gabrielgr04072005-ai/TCC-Fatec-Sistema-de-monitoramento-CNC/Imagens/Amperimetro.jpeg

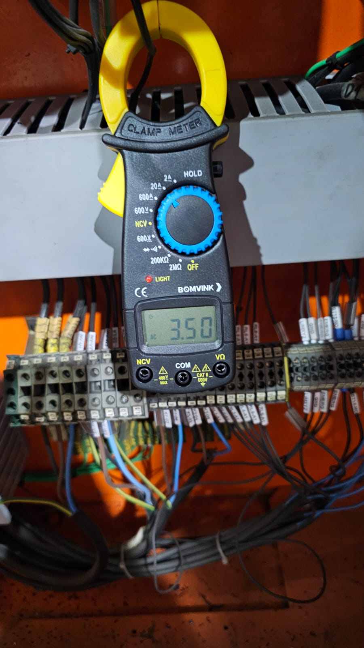
Imagens/Amperimetro.jpeg
