gabrielgr04072005-ai/TCC-Fatec-Sistema-de-monitoramento-CNC/README.md

# TCC Fatec Sistema de monitoramento CNC
Sistema de monitoramento de máninhas CNC da empressa AMJ
