gabrielgr04072005-ai/TCC-Fatec-Sistema-de-monitoramento-CNC/Melhorias/Melhorias_TCC_IIOT_Tamboreadoras.docx

# Plano de Melhorias do TCC – Sistema de Monitoramento de Tamboreadoras Industriais Baseado em IIoT

Principais observações da banca:
A ideia do projeto foi considerada relevante e aplicável, porém faltam detalhamento técnico, fundamentação das decisões, definição clara do problema e melhor estruturação metodológica.

## 1. Melhorar a definição do problema

Descrever o problema atual da empresa antes de apresentar a solução. Explicar a dependência de coletas manuais, deslocamento de técnicos, falta de histórico confiável, erros de registro e dificuldades na manutenção preventiva.

## 2. Caracterizar melhor a empresa

Informar quantidade de tamboreadoras, operadores, técnicos, turnos, frequência das coletas e volume de leituras realizadas.

## 3. Inserir métricas atuais

Apresentar indicadores da situação atual para futura comparação, como tempo médio de coleta, deslocamento, erros de registro e disponibilidade.

## 4. Detalhar os KPIs

Explicar MTBF, MTTR e Disponibilidade, incluindo fórmulas e aplicação no projeto.

## 5. Justificar a escolha da corrente elétrica

Demonstrar por que a corrente foi escolhida, quais benefícios oferece e quais limitações possui.

## 6. Comparar tecnologias alternativas

Apresentar comparação entre método manual, software CMMS, CLP industrial e solução IIoT baseada em ESP32.

## 7. Revisar a utilização do TinyML

Evitar prometer implementação sem definição clara. Apresentar como possibilidade futura da arquitetura.

## 8. Detalhar a arquitetura proposta

Explicar individualmente sensor, ESP32, MQTT, banco de dados, dashboard e usuários.

## 9. Explicar modo online e offline

Detalhar comportamento do sistema quando houver conexão e quando houver falha de comunicação.

## 10. Definir frequência de aquisição

Justificar tecnicamente o intervalo de coleta e transmissão dos dados.

## 11. Revisar inconsistências

Corrigir siglas, trechos indevidos, referências, formatação e erros de escrita.

## 12. Fortalecer a conclusão

Apresentar benefícios esperados, limitações e sugestões de trabalhos futuros.

## Resumo das ações prioritárias

- Explicar claramente o problema.
- Caracterizar a empresa e o processo.
- Inserir métricas atuais e futuras.
- Detalhar KPIs.
- Justificar o uso da corrente elétrica.
- Comparar tecnologias alternativas.
- Reduzir dependência do TinyML no TCC I.
- Detalhar arquitetura.
- Explicar operação online e offline.
- Definir frequência de coleta.
- Revisar todo o documento.
- Ampliar a conclusão.
