gabrielgr04072005-ai/TCC-Fatec-Sistema-de-monitoramento-CNC/Imagens/arquitetura_autoencoder_10_8_4_8_10_v1.png

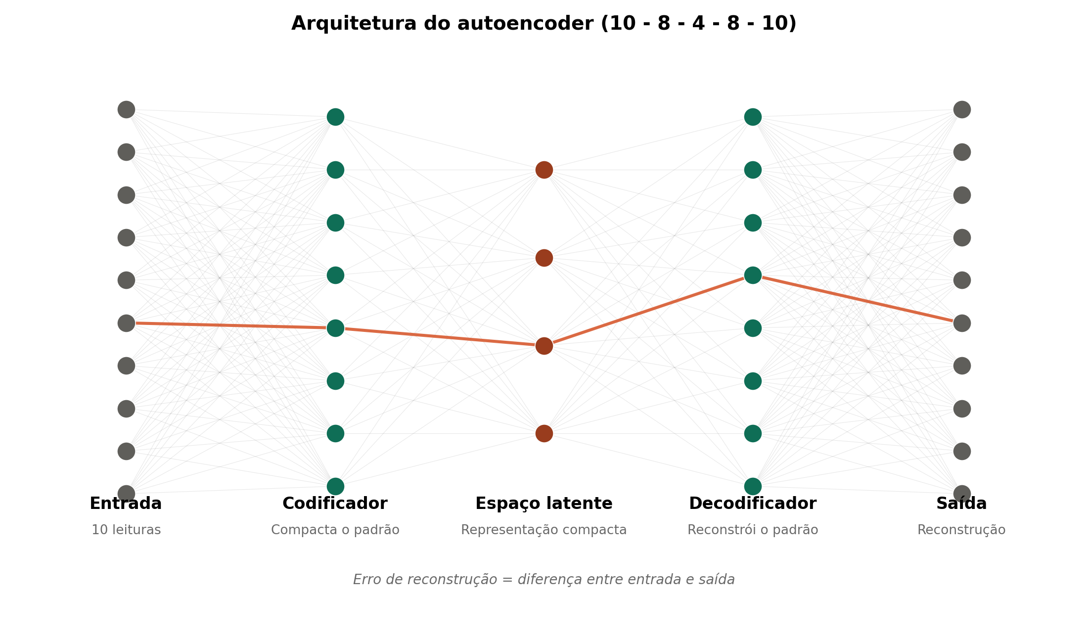
Imagens/arquitetura_autoencoder_10_8_4_8_10_v1.png
