gabrielgr04072005-ai/TCC-Fatec-Sistema-de-monitoramento-CNC/Imagens/autoencoder_4_2_4_v1.png

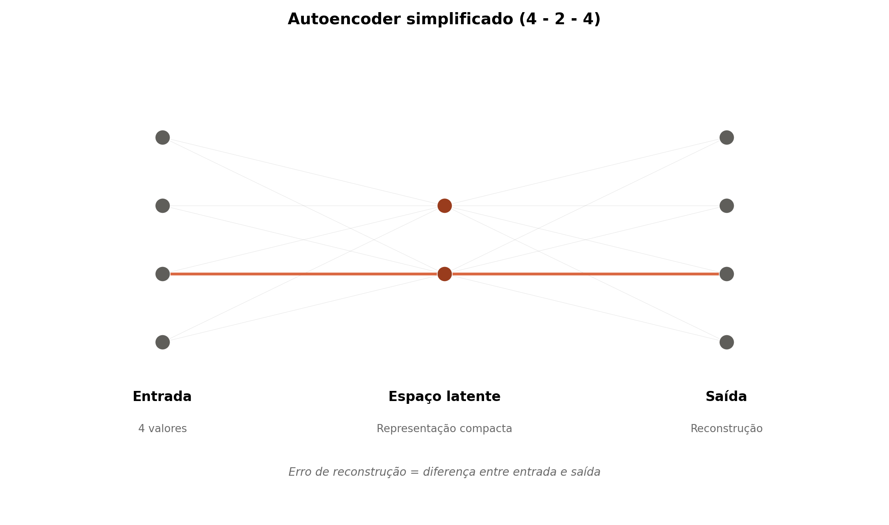
Imagens/autoencoder_4_2_4_v1.png
