gabrielgr04072005-ai/TCC-Fatec-Sistema-de-monitoramento-CNC/Imagens/Circuito_completo.jpg

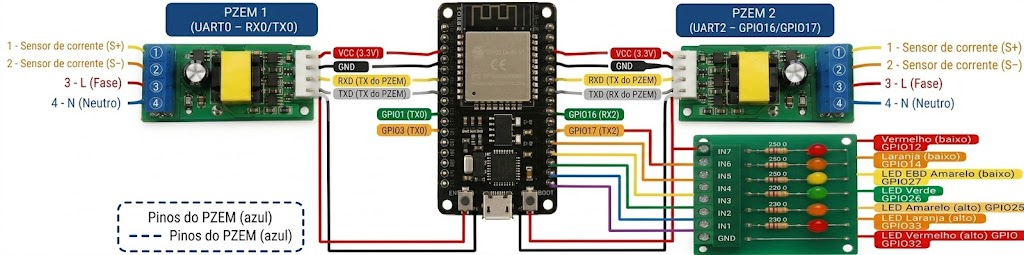
Imagens/Circuito_completo.jpg
