gabrielgr04072005-ai/TCC-Fatec-Sistema-de-monitoramento-CNC/Imagens/ESP32_circuito.png

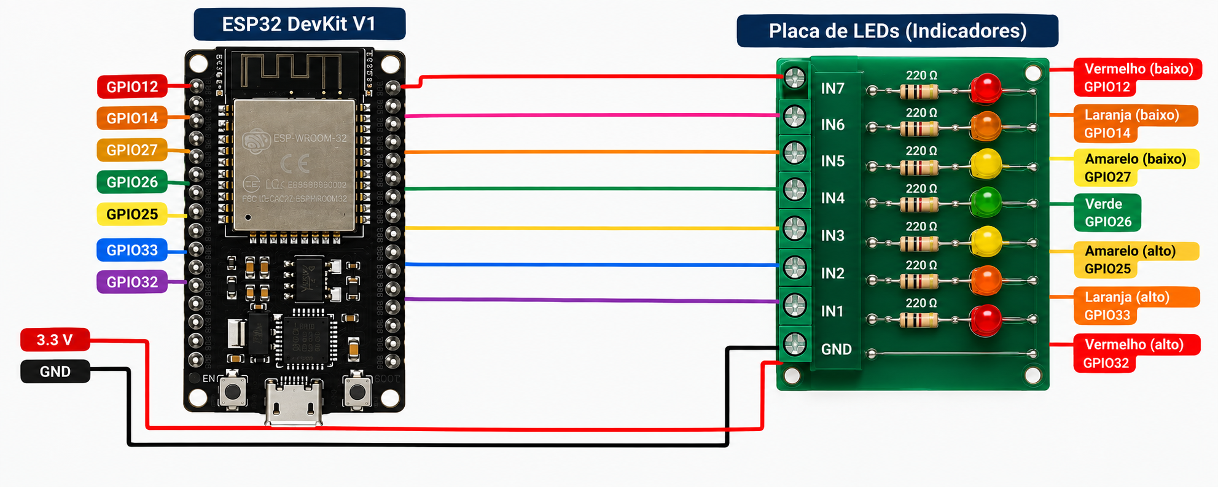
Imagens/ESP32_circuito.png
