gabrielgr04072005-ai/TCC-Fatec-Sistema-de-monitoramento-CNC/Imagens/Fluxograma.png

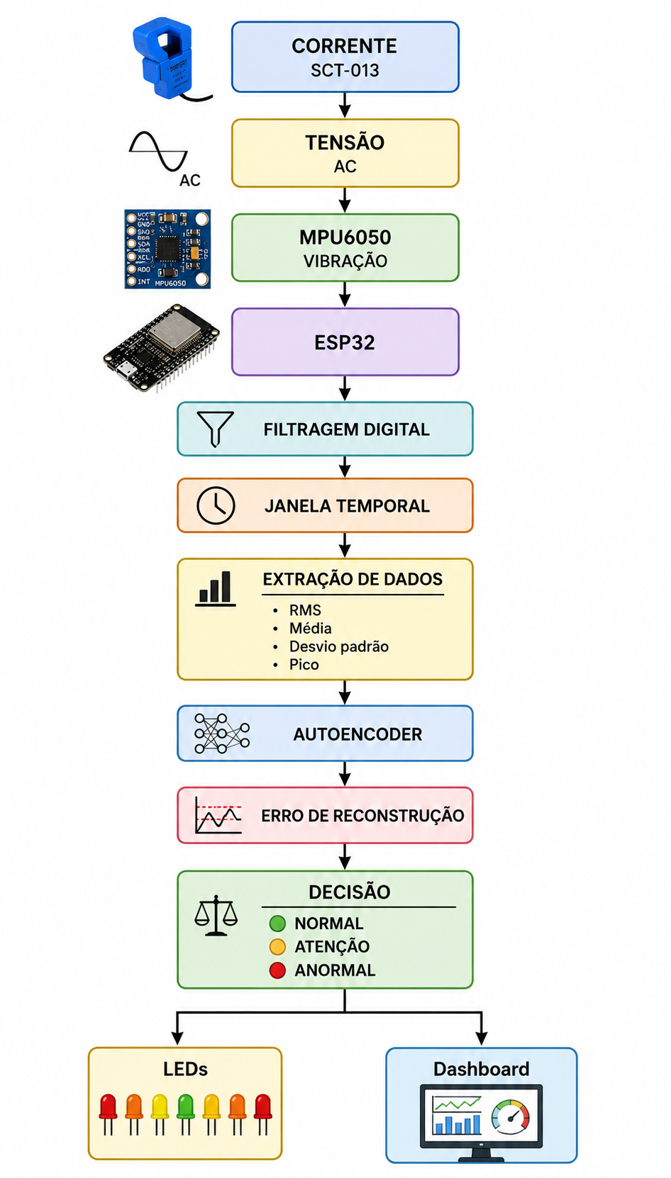
Imagens/Fluxograma.png
