gabrielgr04072005-ai/TCC-Fatec-Sistema-de-monitoramento-CNC/Imagens/Gráfico_ZScore03.10/grafico_leigo_2_mesma_escala.png

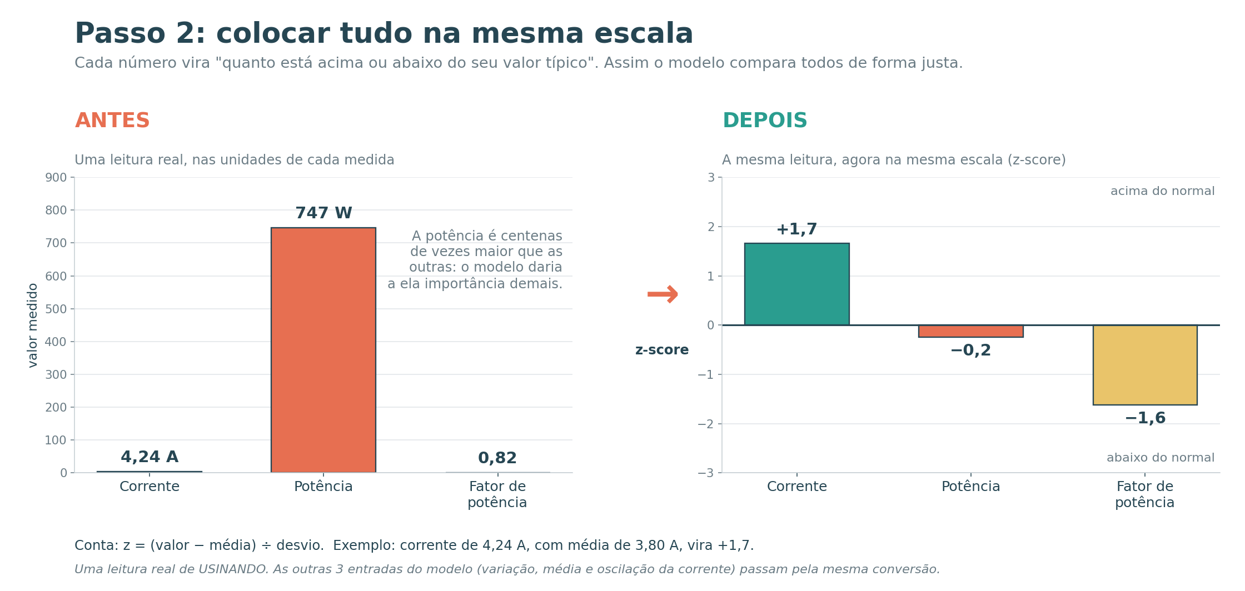
Imagens/Gráfico_ZScore03.10/grafico_leigo_2_mesma_escala.png
