gabrielgr04072005-ai/TCC-Fatec-Sistema-de-monitoramento-CNC/Imagens/Ligação_EPS_32_Pzem.png

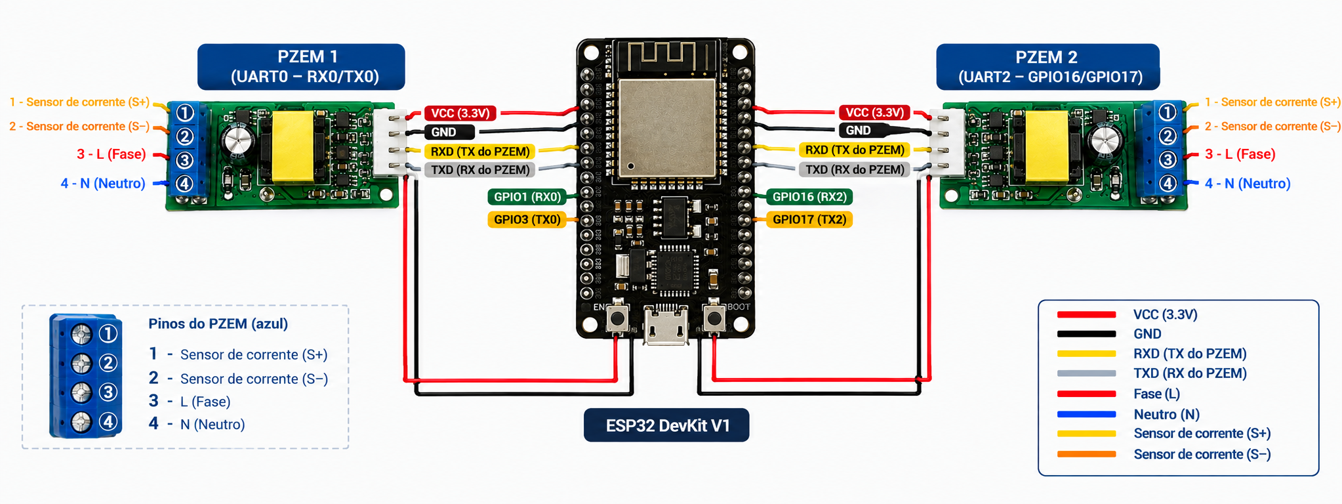
Imagens/Ligação_EPS_32_Pzem.png
