gabrielgr04072005-ai/TCC-Fatec-Sistema-de-monitoramento-CNC/Imagens/Máquina.jpeg

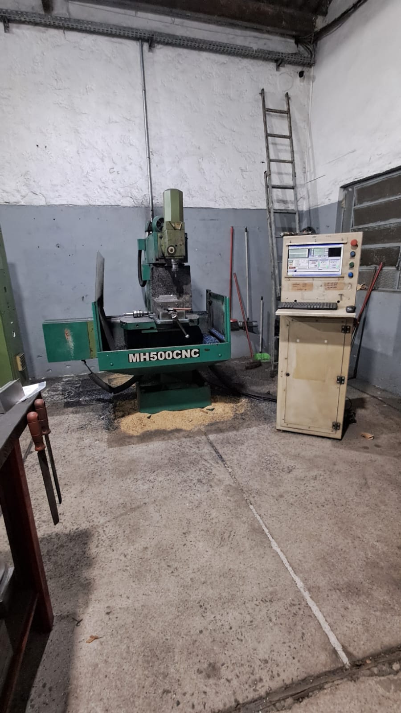
Imagens/Máquina.jpeg
