gabrielgr04072005-ai/TCC-Fatec-Sistema-de-monitoramento-CNC/Imagens/Máquina_operandop.jpeg

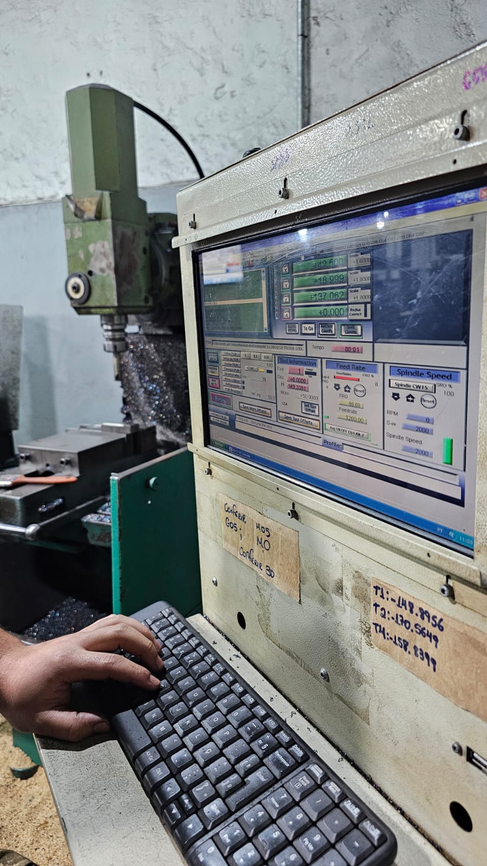
Imagens/Máquina_operandop.jpeg
