gabrielgr04072005-ai/TCC-Fatec-Sistema-de-monitoramento-CNC/Imagens/WhatsApp Image 2026-10-24 at 09.30.09.jpeg

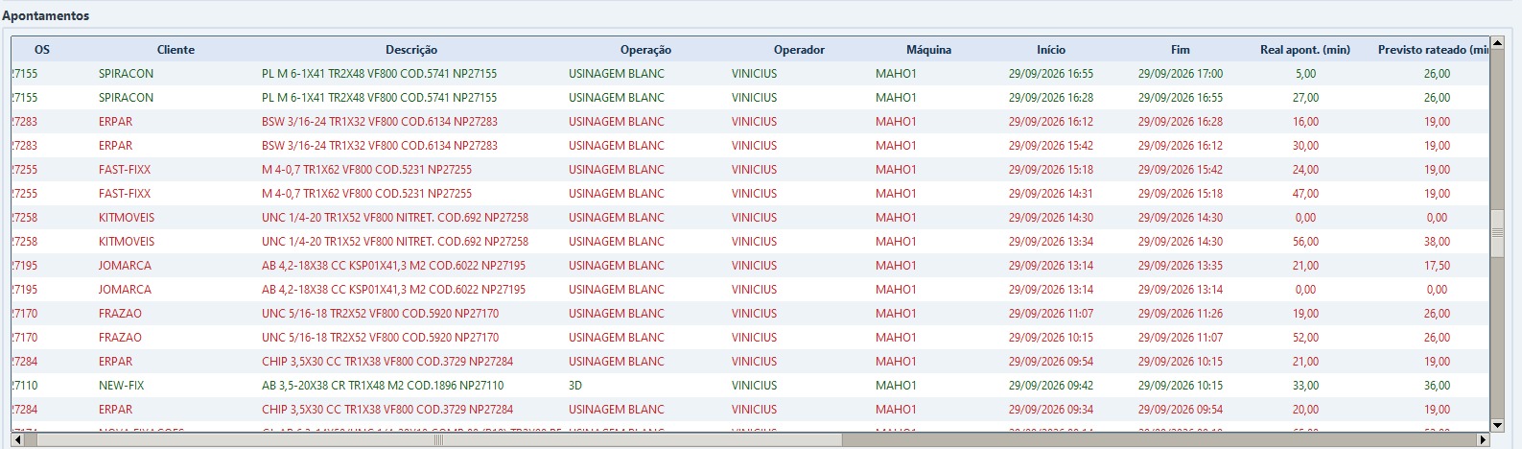
Imagens/WhatsApp Image 2026-10-24 at 09.30.09.jpeg
