gabrielgr04072005-ai/TCC-Fatec-Sistema-de-monitoramento-CNC/Mqtt/Dados brutos/Treino Autoencoder/Treino com o Z score local/boxplot_erro_por_nivel.png

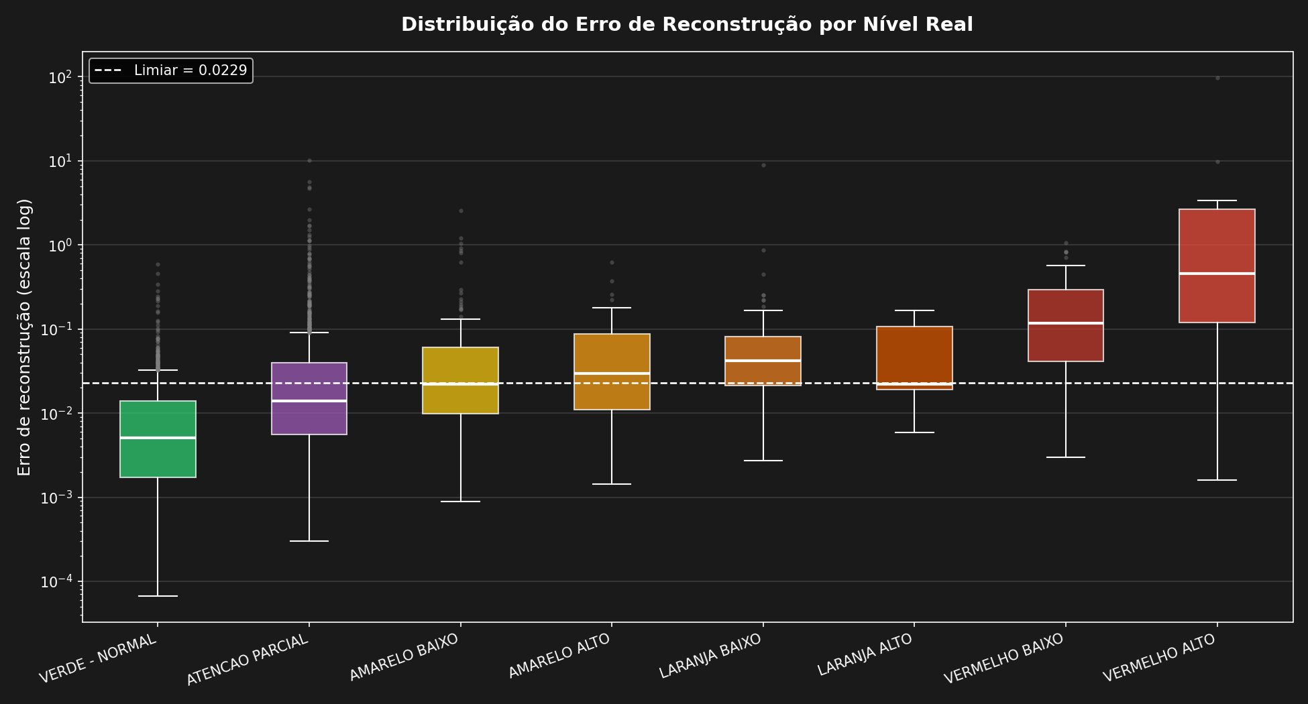
Mqtt/Dados brutos/Treino Autoencoder/Treino com o Z score local/boxplot_erro_por_nivel.png
