gabrielgr04072005-ai/TCC-Fatec-Sistema-de-monitoramento-CNC/Mqtt/Dados brutos/Treino Autoencoder/Treino com o Z score local/dispersao_corrente_vibracao.png

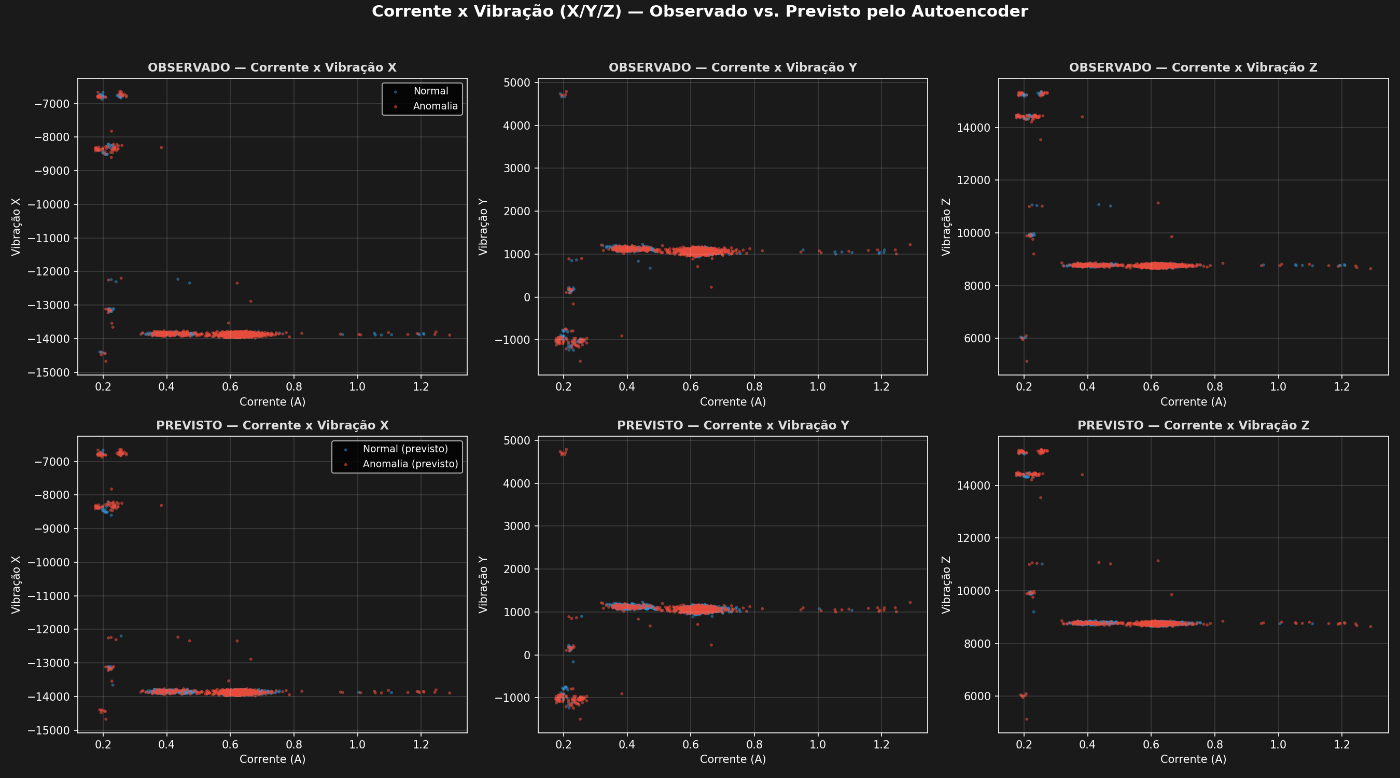
Mqtt/Dados brutos/Treino Autoencoder/Treino com o Z score local/dispersao_corrente_vibracao.png
