gabrielgr04072005-ai/TCC-Fatec-Sistema-de-monitoramento-CNC/Mqtt/Dados brutos/Treino Autoencoder/Treino com o Z score local/erro_tempo_observado_previsto.png

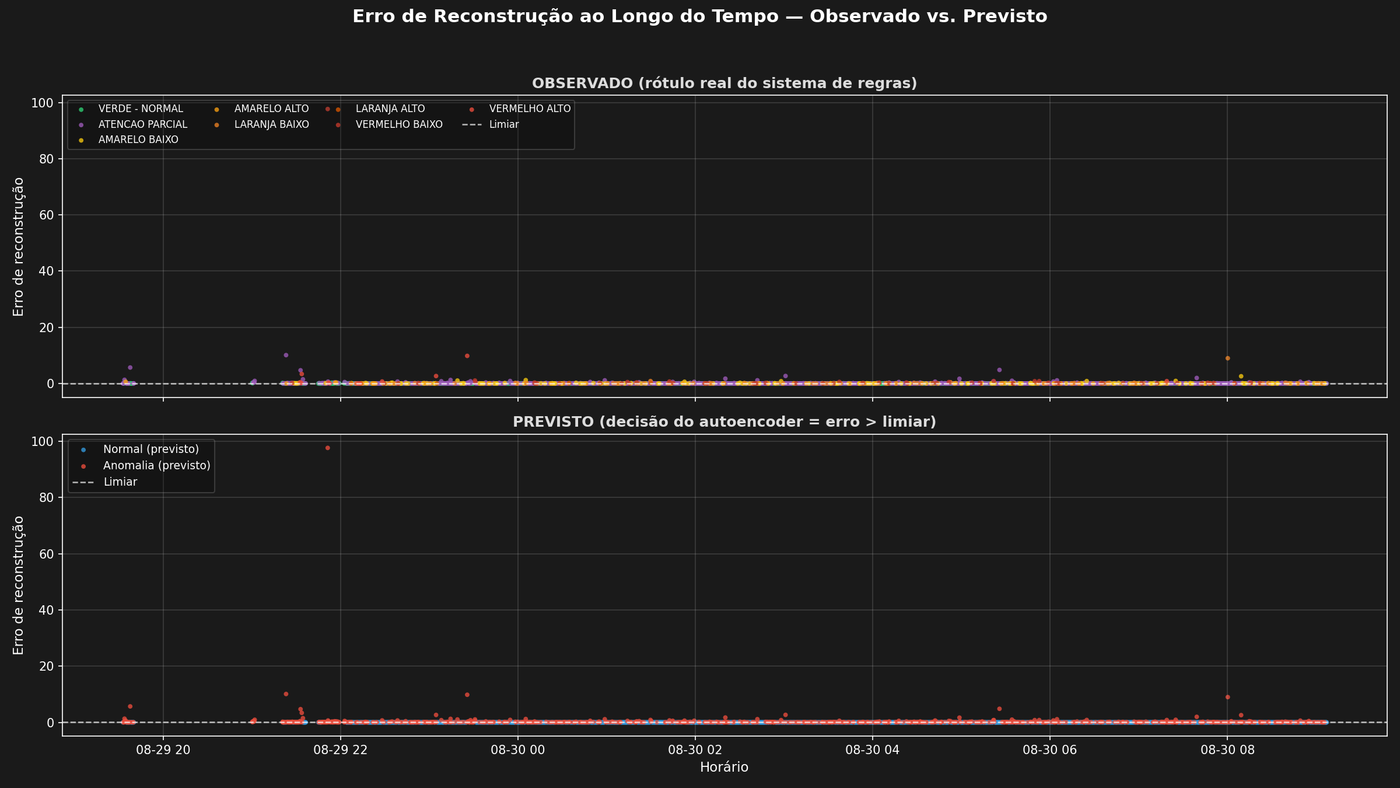
Mqtt/Dados brutos/Treino Autoencoder/Treino com o Z score local/erro_tempo_observado_previsto.png
