gabrielgr04072005-ai/TCC-Fatec-Sistema-de-monitoramento-CNC/Mqtt/Dados brutos/Treino Autoencoder/Treino com o Z score local/grafico_variaveis_v3c.png

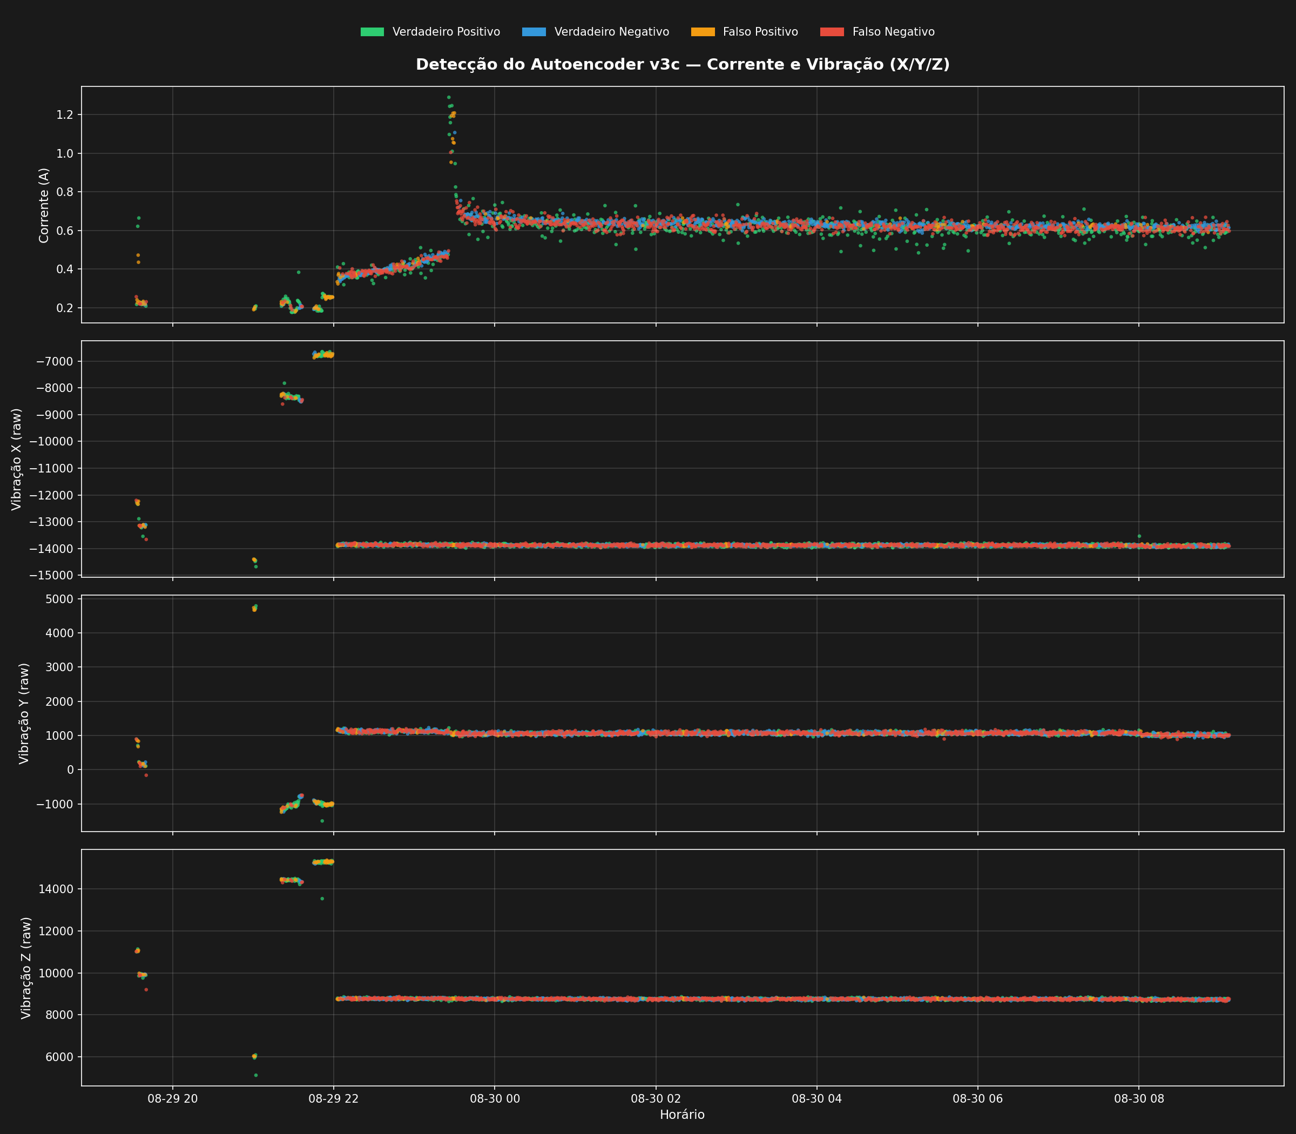
Mqtt/Dados brutos/Treino Autoencoder/Treino com o Z score local/grafico_variaveis_v3c.png
