gabrielgr04072005-ai/TCC-Fatec-Sistema-de-monitoramento-CNC/Treinamento TynML/amostra30.09/estrutura_rede_USINANDO.png

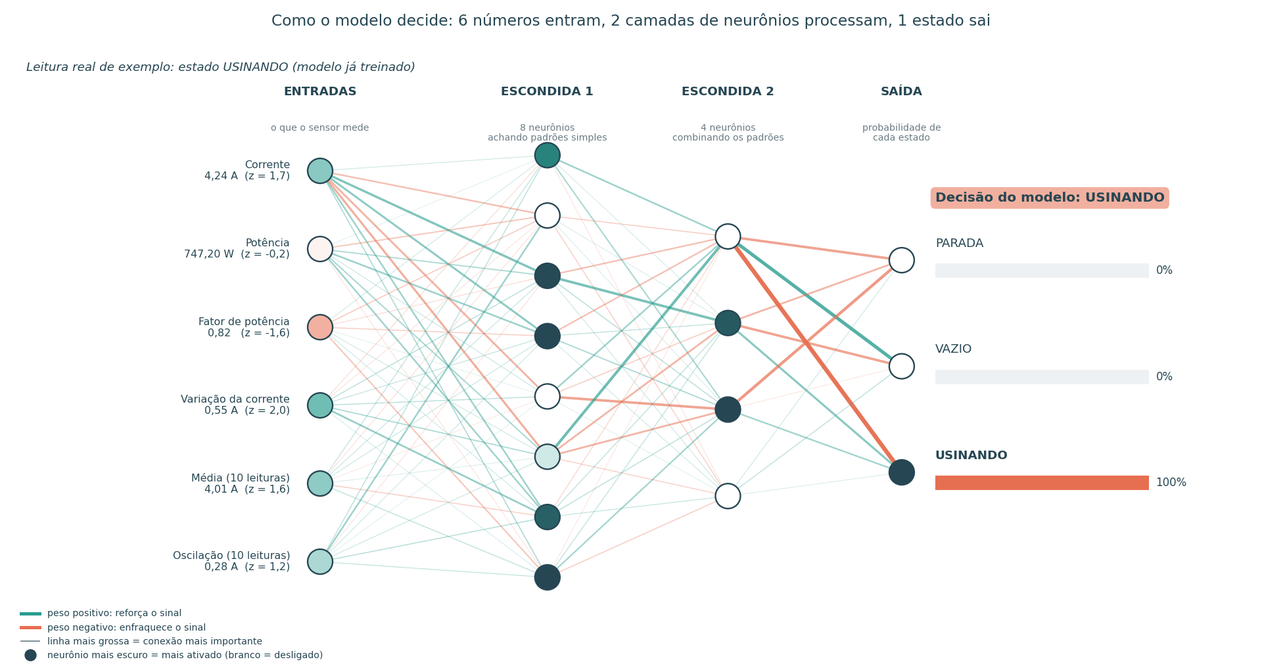
Treinamento TynML/amostra30.09/estrutura_rede_USINANDO.png
