gabrielgr04072005-ai/TCC-Fatec-Sistema-de-monitoramento-CNC/Treinamento TynML/amostra30.09/grafico_3d_variaveis.png

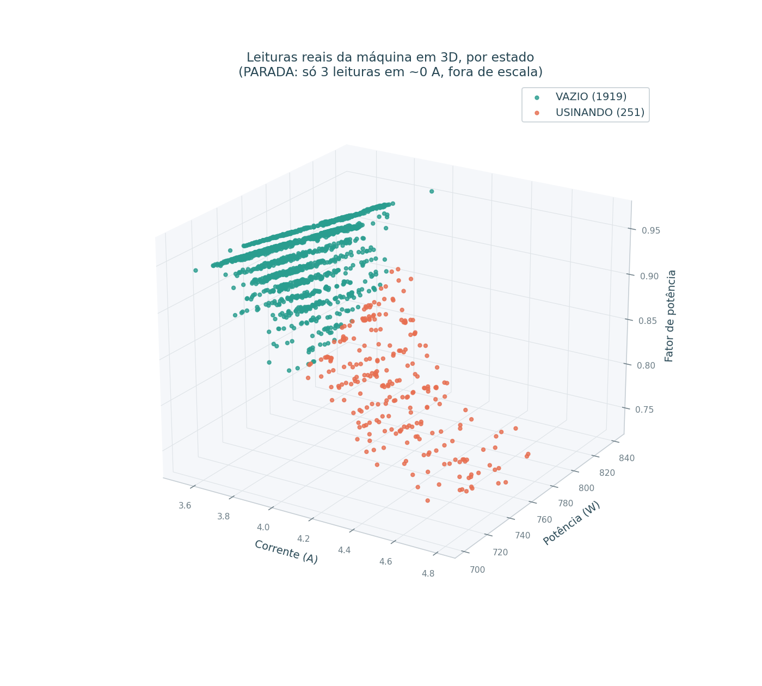
Treinamento TynML/amostra30.09/grafico_3d_variaveis.png
