gabrielgr04072005-ai/TCC-Fatec-Sistema-de-monitoramento-CNC/Treinamento TynML/amostra30.09/saida_tcc/estrutura_rede_VAZIO.png

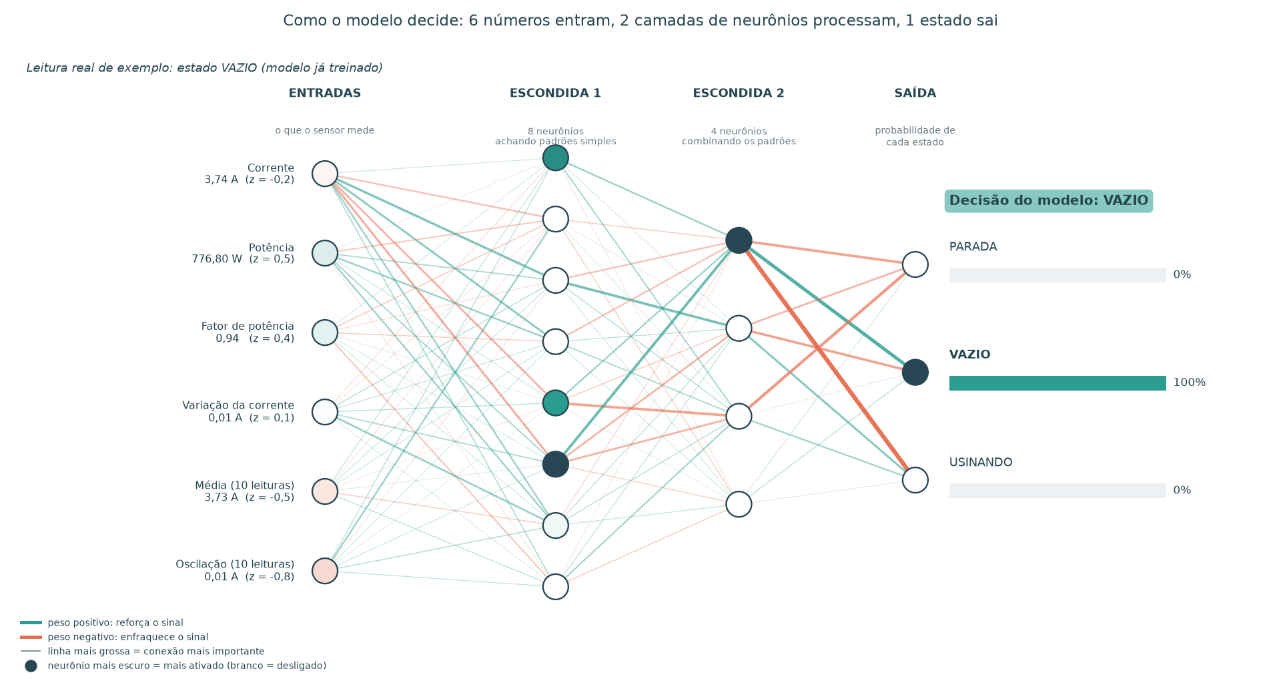
Treinamento TynML/amostra30.09/saida_tcc/estrutura_rede_VAZIO.png
