gabrielgr04072005-ai/TCC-Fatec-Sistema-de-monitoramento-CNC/Treinamento TynML/amostra30.09/saida_tcc/treino_animado.gif

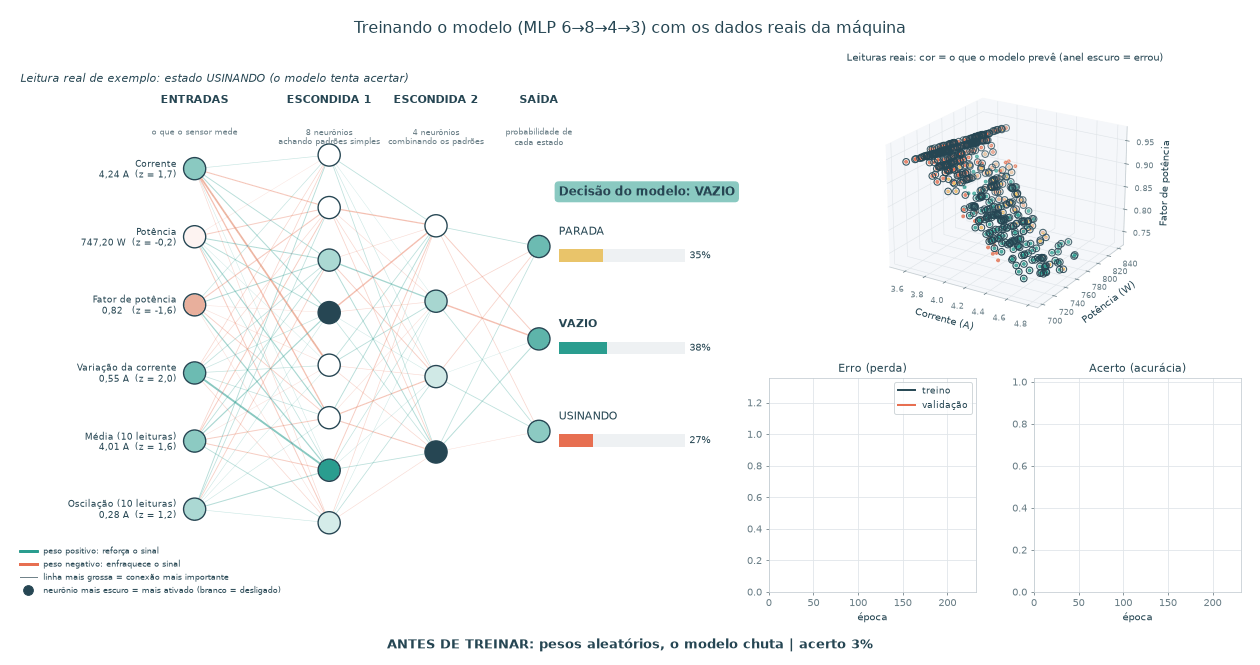
Treinamento TynML/amostra30.09/saida_tcc/treino_animado.gif
