gabrielgr04072005-ai/TCC-Fatec-Sistema-de-monitoramento-CNC/Treinamento TynML/Dados reais 23_08/leituras_reais_planilha.png

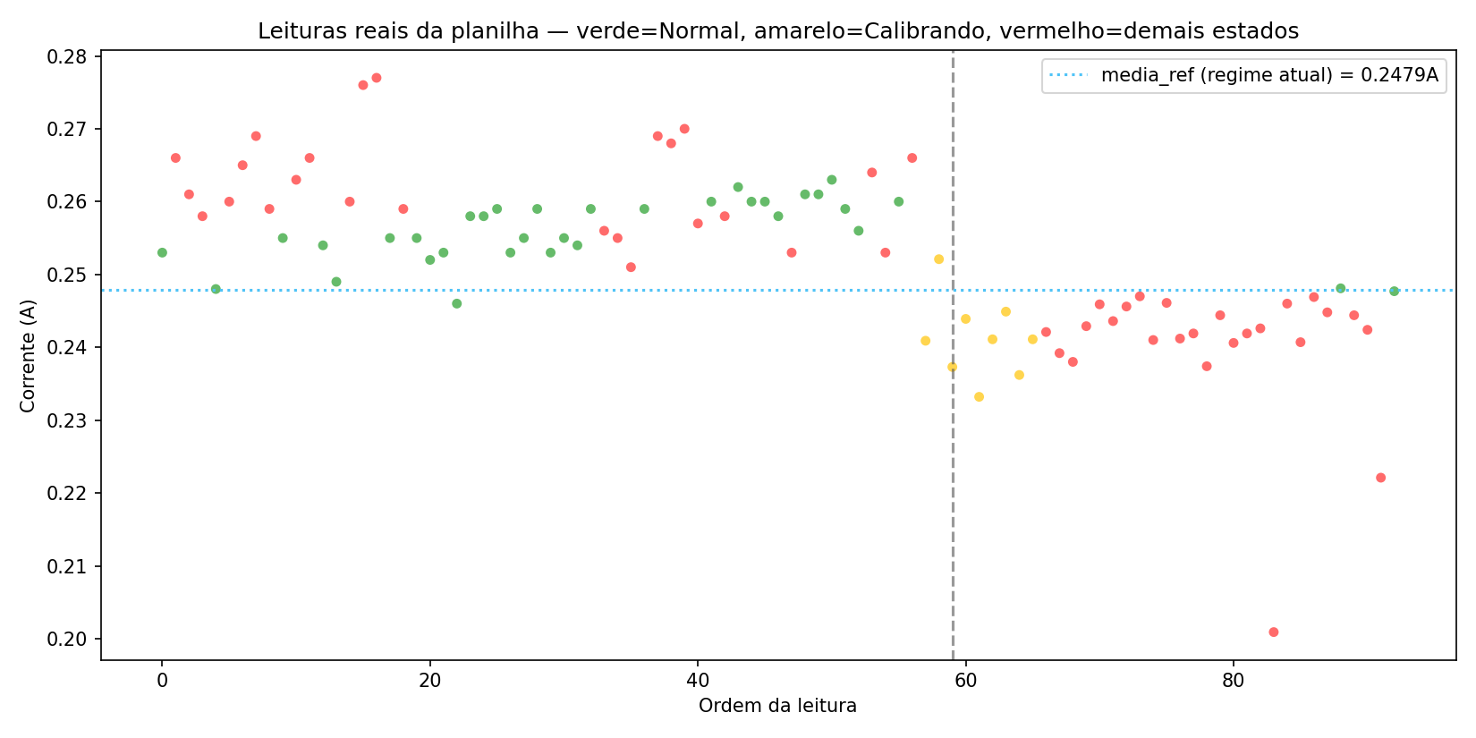
Treinamento TynML/Dados reais 23_08/leituras_reais_planilha.png
