gabrielgr04072005-ai/TCC-Fatec-Sistema-de-monitoramento-CNC/Treinamento TynML/Dados reais 23_08/matriz_confusao_dados_reais.png

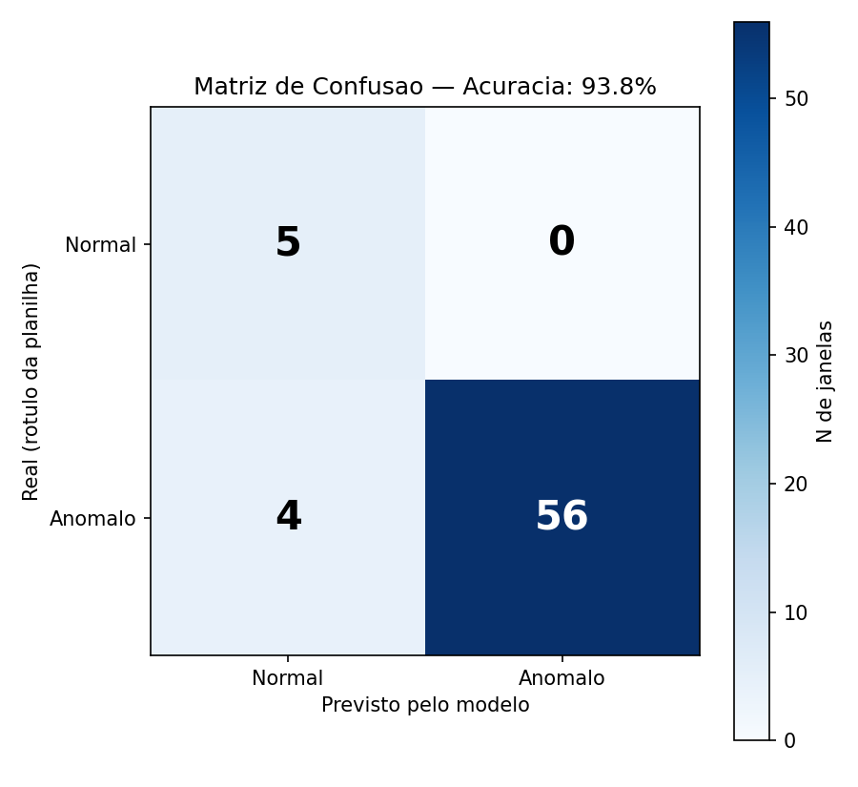
Treinamento TynML/Dados reais 23_08/matriz_confusao_dados_reais.png
