gabrielgr04072005-ai/TCC-Fatec-Sistema-de-monitoramento-CNC/Treinamento TynML/fluxo_deploy_autoencoder.png

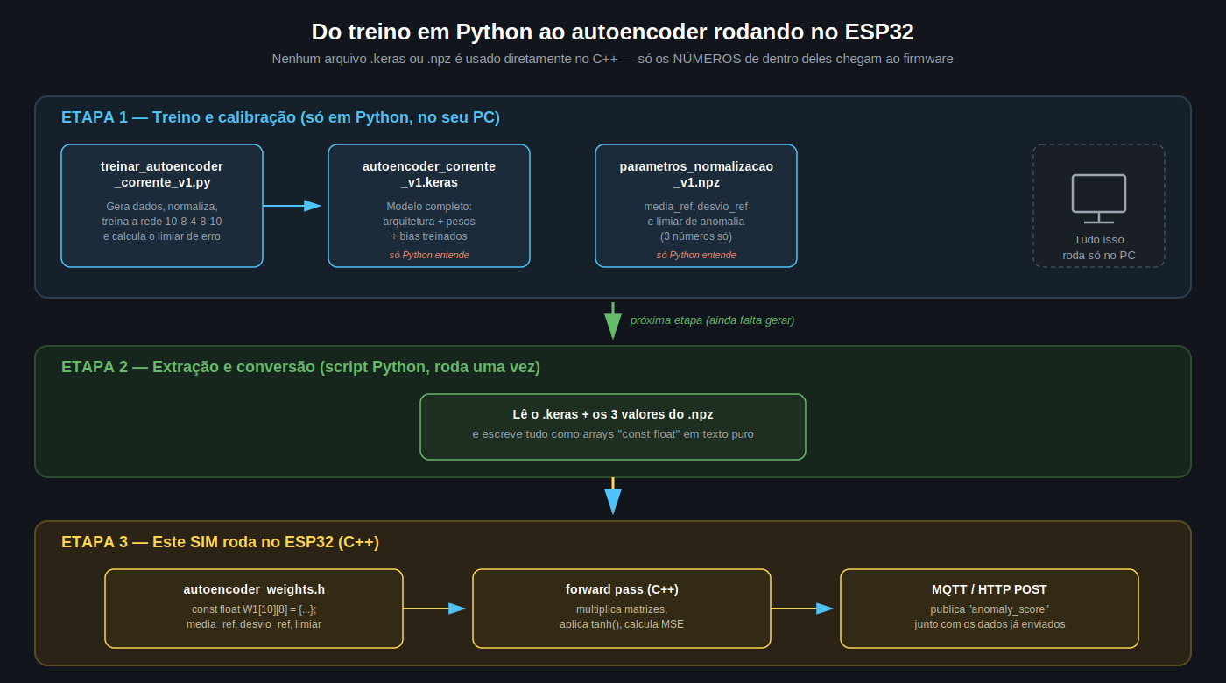
Treinamento TynML/fluxo_deploy_autoencoder.png
