gabrielgr04072005-ai/TCC-Fatec-Sistema-de-monitoramento-CNC/Treinamento TynML/Treinameto_25a26do9/treinamento_visual.png

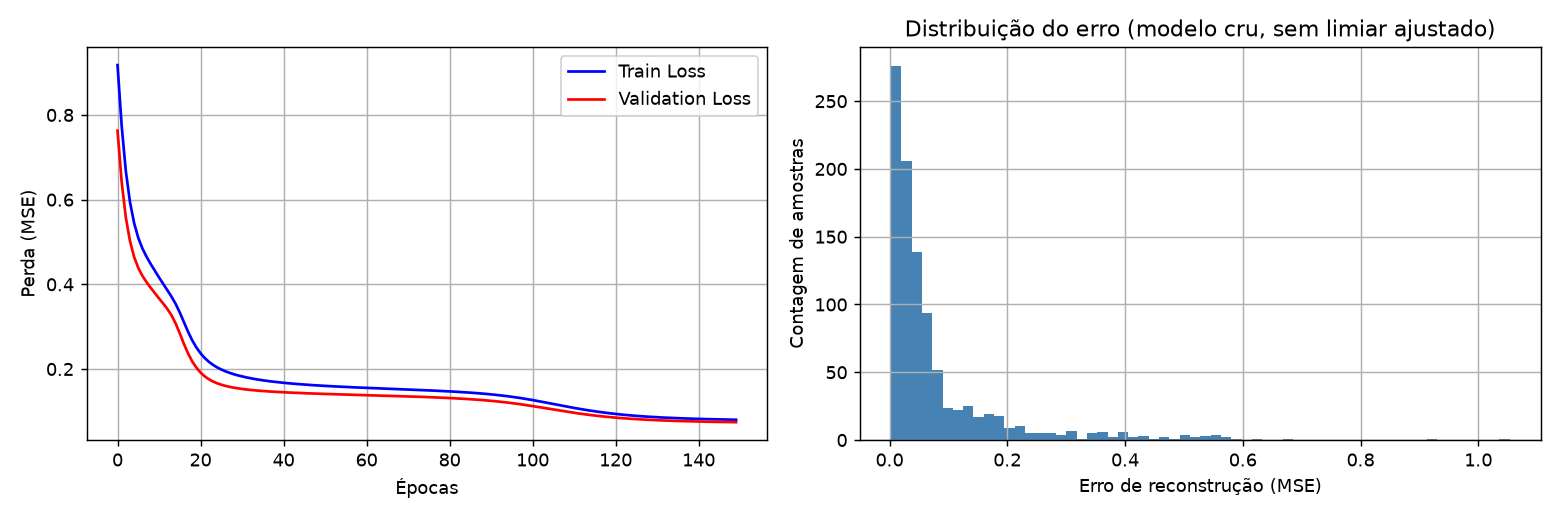
Treinamento TynML/Treinameto_25a26do9/treinamento_visual.png
