gabrielgr04072005-ai/TCC-Fatec-Sistema-de-monitoramento-CNC/material de estudo/Material de apoio.docx

1. Primeiro: o que é Machine Learning?

Machine Learning é uma abordagem em que você não programa explicitamente todas as regras de decisão. Você fornece dados, e um algoritmo encontra relações nesses dados para produzir uma previsão ou classificação.

No seu projeto, em vez de programar somente:

corrente > 4 A → USINANDO

corrente < 4 A → VAZIO

você fornece ao modelo várias características da máquina:

Corrente

Potência

Fator de potência

Variação da corrente

Média da corrente

Desvio-padrão da corrente

e ele aprende uma relação entre essas entradas e os rótulos de operação.

A ideia geral é:

DADOS

↓

ALGORITMO DE APRENDIZADO

↓

MODELO TREINADO

↓

NOVOS DADOS

↓

PREDIÇÃO

2. Onde entra o MLP?

MLP significa:

Multilayer Perceptron

ou

Perceptron Multicamadas.

É uma rede neural artificial.

A palavra "multicamadas" é importante porque ela não possui somente um neurônio ou uma única camada. Ela possui:

ENTRADA

↓

CAMADA OCULTA 1

↓

CAMADA OCULTA 2

↓

SAÍDA

No seu caso:

6 → 8 → 4 → 3

Ou seja:

6 entradas

↓

8 neurônios

↓

4 neurônios

↓

3 neurônios

A estrutura do seu projeto está documentada exatamente dessa forma.

3. O que é um neurônio?

O neurônio artificial é uma unidade matemática.

Ele recebe várias entradas, multiplica cada entrada por um peso, soma tudo, adiciona um viés e depois passa o resultado por uma função de ativação.

A equação é:

z=w_1 x_1 +w_2 x_2 +⋯+w_n x_n +b

Depois:

a=f(z)

Onde:

x = entrada
w = peso
b = bias
z = soma ponderada
f = função de ativação
a = saída do neurônio

No documento do seu projeto, essa é justamente a operação definida para cada neurônio.

4. O que são os pesos?

Essa é uma das coisas mais importantes para entender.

Imagine que o modelo receba:

Corrente = 4,2 A

Potência = 800 W

Fator de potência = 0,91

O modelo precisa descobrir quanto cada variável influencia a decisão.

Por exemplo, conceitualmente:

Corrente → peso grande

Potência → peso médio

Fator de pot. → peso menor

Esses números são os pesos.

Durante o treinamento, o modelo vai alterando esses valores.

Por isso você pode pensar:

O aprendizado da rede acontece principalmente pelo ajuste dos pesos e vieses.

No seu MLP existem 107 parâmetros treináveis. Isso inclui pesos e vieses.

E dá para conferir:

Primeira camada

6 entradas × 8 neurônios:

6×8=48

Mais 8 vieses:

48+8=56

Segunda camada

8 × 4:

8×4=32

Mais 4 vieses:

32+4=36

Saída

4 × 3:

4×3=12

Mais 3 vieses:

12+3=15

Total:

56+36+15=107

Portanto, os 107 "ajustes" que aparecem no material estão corretos.

5. Como a sua rede funciona na prática?

Imagine uma leitura da máquina:

Corrente = 4,24 A

Potência = ...

Fator de potência = ...

Variação = ...

Média = ...

Desvio padrão = ...

Primeiro os valores passam pelo pré-processamento.

No seu projeto, há tratamento de outliers com MAD e normalização por z-score.

Depois:

6 valores

↓

NORMALIZAÇÃO

↓

MLP

A primeira camada recebe os seis valores.

Cada um dos 8 neurônios calcula:

z=Wx+b

e aplica ReLU.

Depois esses 8 resultados passam para os 4 neurônios da segunda camada.

Novamente:

z=Wx+b

e ReLU.

Finalmente os quatro valores chegam aos três neurônios de saída.

6. Por que ReLU?

No seu projeto, as duas camadas ocultas usam ReLU.

A função é:

ReLU(x)=max⁡(0, x)

Então:

x < 0 → 0

x > 0 → x

Exemplo:

-3 → 0

-1 → 0

0 → 0

2 → 2

5 → 5

A ReLU introduz uma não linearidade na rede.

Isso é fundamental.

Sem funções de ativação não lineares, várias camadas lineares poderiam ser matematicamente reduzidas a uma transformação linear única. Assim, a rede teria dificuldade para representar fronteiras mais complexas entre os estados.

Seu material explica exatamente essa motivação para a escolha da ReLU.

7. E a saída? Por que softmax?

Você possui três saídas:

PARADA

VAZIO

USINANDO

A camada de saída usa softmax.

Ela transforma as pontuações da rede em probabilidades que somam 100%.

Por exemplo:

PARADA = 0,05

VAZIO = 0,15

USINANDO = 0,80

Então:

PARADA 5%

VAZIO 15%

USINANDO 80%

O modelo escolhe:

USINANDO

porque é a maior probabilidade.

8. O que acontece no Forward Propagation?

Esse é o primeiro grande passo do funcionamento da rede.

O dado vai:

ENTRADA

↓

CAMADA 1

↓

CAMADA 2

↓

SAÍDA

Por isso é chamado de forward propagation, ou propagação direta.

No seu projeto:

6 variáveis

↓

8 neurônios + ReLU

↓

4 neurônios + ReLU

↓

3 neurônios + Softmax

↓

probabilidades

Seu documento resume exatamente essa sequência.

9. Mas como a rede sabe que errou?

Aí entra a função de perda (loss).

Suponha que a resposta correta seja:

USINANDO

Mas o modelo respondeu:

PARADA 40%

VAZIO 29%

USINANDO 31%

Ele errou.

A função de perda mede o tamanho desse erro.

No seu projeto é utilizada entropia cruzada categórica.

A equação, no caso simplificado de uma classe correta, fica:

L=-ln⁡(p)

onde p é a probabilidade que o modelo atribuiu à classe correta.

Se a rede der 90% para a classe correta:

L=-ln⁡(0, 9)≈0,11

Erro pequeno.

Se der apenas 10%:

L=-ln⁡(0, 1)≈2,30

Erro muito maior.

Isso faz com que a rede seja fortemente penalizada quando erra com confiança.

10. Agora chegamos ao BACKPROPAGATION

Esse é provavelmente o ponto que você mais precisa dominar.

A imagem que você enviou mostra o processo em nove passos.

Vamos adaptar os nove passos para a sua MLP.

PASSO 1 — Inicializar os pesos

Antes de aprender, a rede precisa possuir pesos.

No seu treinamento, eles começam com valores iniciais aleatórios.

w₁ = ...

w₂ = ...

w₃ = ...

No início a rede ainda não sabe nada.

Então ela praticamente "chuta".

O seu material mostra essa condição como a época inicial do treinamento.

11. PASSO 2 — Propagar a entrada até a saída

Agora entra uma leitura real da máquina.

Por exemplo:

x₁ = corrente

x₂ = potência

x₃ = fator de potência

x₄ = Δ corrente

x₅ = média

x₆ = desvio padrão

Esses seis valores passam pelas camadas:

6

↓

8

↓

4

↓

3

Esse é o forward propagation.

12. PASSO 3 — Calcular o erro

A saída pode ser:

PARADA 5%

VAZIO 64%

USINANDO 31%

Mas o rótulo real é:

USINANDO

A função de perda calcula:

L=-ln⁡(0, 31)

aproximadamente:

L=1,16

Esse exemplo aparece diretamente no material do treinamento.

13. O que é o delta?

O delta está relacionado ao erro que precisa ser propagado para trás para determinar como cada parâmetro deve ser ajustado.

Em termos intuitivos:

"Quanto esse neurônio/peso contribuiu para o erro?"

O cálculo vem da aplicação da regra da cadeia e das derivadas.

É por isso que você vê:

(∂L)/(∂w)

Essa expressão significa:

quanto a perda L muda quando alteramos um determinado peso w .

O documento explica o gradiente justamente como a inclinação da perda em relação a cada peso.

14. PASSO 4 — Ajustar os pesos da saída

Agora sabemos para que lado o peso precisa mudar.

A atualização conceitual é:

w_(novo) =w_(antigo) -η(∂L)/(∂w)

Onde:

- w = peso;
- L = perda;
- (∂L)/(∂w) = gradiente;
- η = taxa de aprendizado.

No seu treinamento, o Adam parte de:

η=0,001

15. PASSO 5 — Voltar para a última camada oculta

Depois de corrigir o erro da saída, o algoritmo continua voltando.

Por isso o nome:

backpropagation

"Back" = para trás.

"Propagation" = propagação.

Então:

SAÍDA

↓

CAMADA OCULTA 2

↓

CAMADA OCULTA 1

↓

ENTRADAS

O algoritmo calcula os gradientes utilizando a regra da cadeia.

16. PASSO 6 — Ajustar os pesos da camada oculta

Agora os pesos da segunda camada oculta também são corrigidos.

Depois:

CAMADA 2 → corrige

CAMADA 1 → corrige

Até alcançar a primeira camada.

17. PASSO 7 — Repetir até a primeira camada

O erro vai sendo propagado para trás:

ERRO

↑

SAÍDA

↑

OCULTA 2

↑

OCULTA 1

↑

ENTRADA

É justamente essa sequência que o algoritmo da imagem está mostrando.

18. PASSO 8 — Repetir para os dados do treinamento

Agora pega outra leitura.

E novamente:

FORWARD

↓

LOSS

↓

BACKPROPAGATION

↓

ATUALIZAÇÃO

Isso acontece para os exemplos do treinamento.

No seu caso, os dados são processados em mini-batches de 32 leituras.

19. O que é um mini-batch?

Imagine que você tenha milhares de leituras.

Você poderia tentar usar tudo de uma vez.

Mas o treinamento divide os dados em pequenos grupos:

32 leituras

32 leituras

32 leituras

32 leituras

Cada grupo é um mini-batch.

Em cada mini-batch:

forward

↓

loss

↓

backpropagation

↓

atualização

20. O que é uma época?

Agora chegamos a outra coisa que você precisa saber explicar.

Uma época é uma passagem completa por todo o conjunto de treinamento.

Por exemplo:

2.000 registros

Se o batch tiver 32:

2.000 / 32 ≈ 63 batches

Uma época significa processar todos esses batches uma vez.

Então:

ÉPOCA 1

→ todos os dados

ÉPOCA 2

→ todos novamente

ÉPOCA 3

→ todos novamente

21. Como o seu treinamento evoluiu?

No seu material há uma representação muito boa disso.

Época 0

Os pesos ainda são aleatórios.

A rede praticamente chuta.

Época 10

A rede já começa a separar VAZIO de USINANDO.

Época 40

O modelo está fazendo ajustes mais finos e o erro continua diminuindo, mas mais lentamente.

Época 206

Foi encontrado o melhor conjunto de pesos segundo a validação.

O treinamento continuou até 231, mas o early stopping recuperou os pesos da época 206.

Isso é uma ótima forma de explicar visualmente o aprendizado.

22. O que é Early Stopping?

Existe um perigo:

overfitting.

A rede pode começar a ficar excelente nos dados de treinamento e piorar nos dados que não foram usados para aprender.

É como um aluno que decora a prova em vez de aprender a matéria.

Por isso vocês usam dados de validação.

Quando a validação deixa de melhorar por determinado número de épocas, o treinamento para.

No material, a paciência é 25 épocas.

23. O que é Adam?

Adam é o otimizador.

É ele que ajuda a decidir como atualizar os pesos usando os gradientes.

Você pode pensar assim:

Backpropagation

↓

calcula "para onde ir"

Adam

↓

ajuda a determinar "como caminhar"

No seu projeto:

Otimizador = Adam

Learning rate inicial = 0,001

24. Então qual é a diferença entre Backpropagation e Adam?

Essa é uma pergunta de banca que pode aparecer.

Backpropagation calcula os gradientes.

Adam utiliza esses gradientes para realizar as atualizações dos parâmetros de maneira adaptativa.

Simplificando:

ERRO

↓

BACKPROPAGATION

↓

GRADIENTES

↓

ADAM

↓

NOVOS PESOS

Eles não são a mesma coisa.

25. Quando termina o treinamento?

Quando acontece o critério de parada.

No seu treinamento:

melhor época = 206

treinamento chegou a = 231

paciência = 25

Portanto:

época 206

↓

não houve melhora relevante

↓

espera 25 épocas

↓

época 231

↓

para

↓

recupera pesos da época 206

Isso está documentado no material v3.

26. E depois?

Depois do treinamento começa a inferência.

Essa diferença é fundamental.

Treinamento

dados conhecidos

+

rótulos

↓

aprende pesos

Inferência

novo dado

↓

pesos já treinados

↓

classificação

Seu ESP32 não precisa ficar "aprendendo" continuamente durante a operação.

Ele utiliza o modelo já treinado.

27. Agora: por que MLP e não outro modelo?

Aqui está provavelmente a parte mais importante da sua pergunta.

Não existe um modelo de Machine Learning que seja "o melhor para tudo".

Cada algoritmo tem uma característica.

28. Perceptron simples × MLP

Perceptron simples

Possui uma estrutura muito simples:

ENTRADAS

↓

SAÍDA

Ele consegue resolver problemas linearmente separáveis.

MLP

Possui camadas ocultas:

ENTRADAS

↓

OCULTA

↓

OCULTA

↓

SAÍDA

As funções não lineares permitem modelar relações mais complexas.

No seu projeto, isso é útil para combinar simultaneamente corrente, potência, fator de potência e características temporais.

29. MLP × Regressão Logística

A regressão logística é bastante útil para classificação, especialmente quando a separação pode ser representada de maneira relativamente simples.

Uma visão simplificada:

Entradas

↓

função logística

↓

classe

O MLP é mais flexível porque possui camadas ocultas e ativações não lineares.

Para seu projeto

Regressão logística

→ modelo mais simples

MLP

→ consegue representar relações não lineares mais complexas

Porém, isso não significa que MLP necessariamente teria melhor desempenho em qualquer conjunto de dados.

30. MLP × Árvore de Decisão

Árvore de decisão funciona como uma sequência de perguntas:

Corrente > 4 A?

↓

SIM

↓

Potência > X?

↓

SIM

↓

USINANDO

É muito fácil interpretar.

A grande diferença é que a MLP não trabalha com uma sequência explícita de perguntas.

Ela aprende uma combinação matemática dos atributos através dos pesos.

31. MLP × Random Forest

Random Forest é formada por várias árvores de decisão.

Visualmente:

DADOS

↓

┌───────┼────────┐

↓ ↓ ↓

Árvore Árvore Árvore

↓ ↓ ↓

classe classe classe

└───────┼────────┘

↓

votação

É muito forte para dados tabulares.

Inclusive, seria uma alternativa tecnicamente plausível para o seu problema.

Mas existe uma diferença importante para o seu TCC:

Random Forest

→ conjunto de árvores

MLP

→ operações matriciais + ativações

No seu caso, a MLP foi escolhida também por ser pequena, com apenas 107 parâmetros, adequada à inferência no ESP32. O material do projeto compara a MLP a redes maiores e LSTM justamente nesse contexto.

32. MLP × SVM

SVM significa Support Vector Machine.

A ideia é encontrar uma fronteira que separe as classes.

Imagine:

VAZIO ○ ○ ○ ○

----------------- ← fronteira

USINANDO ● ● ● ●

A SVM tenta encontrar uma fronteira adequada entre os grupos.

Ela pode ser muito eficiente para conjuntos pequenos e médios.

Mas uma MLP é naturalmente baseada em uma sequência de transformações neurais:

X

↓

W₁X+b₁

↓

ReLU

↓

W₂X+b₂

↓

ReLU

↓

W₃X+b₃

↓

Softmax

33. MLP × KNN

KNN significa K-Nearest Neighbors.

Ele não cria, da mesma maneira, uma função paramétrica compacta como a sua MLP.

Quando chega uma leitura nova, ele procura exemplos próximos no conjunto conhecido.

Por exemplo:

novo ponto

↓

procura pontos mais próximos

↓

3 vizinhos = VAZIO

2 vizinhos = USINANDO

↓

VAZIO

É simples, mas pode exigir consultar muitos dados durante a inferência.

No seu projeto isso é menos interessante porque o objetivo é ter um modelo pequeno embarcado.

34. MLP × LSTM

Essa comparação é especialmente importante no seu TCC.

LSTM é uma arquitetura de rede neural especializada em sequências.

Ela tenta preservar informações ao longo do tempo.

Por exemplo:

leitura 1

↓

leitura 2

↓

leitura 3

↓

leitura 4

↓

Ela seria interessante quando você quisesse alimentar o modelo com uma sequência temporal inteira e aprender diretamente padrões temporais.

35. Então por que MLP no seu projeto?

Porque seu problema atual está organizado como dados tabulares/features, e não como uma sequência complexa de centenas de amostras brutas.

Você já transforma o histórico em características:

corrente

potência

fator de potência

Δ corrente

média

desvio padrão

Ou seja, você já extrai algumas informações temporais antes de entregar os dados à rede.

Por isso o MLP se encaixa muito bem na estrutura atual.

O próprio documento registra a decisão:

MLP 6→8→4→3

versus redes maiores/LSTM, com a justificativa de que os dados são tabulares e a rede precisa caber no ESP32.

36. MLP × CNN

CNN é mais conhecida por processamento de imagens, mas também pode ser utilizada em sinais e séries temporais.

Ela utiliza convoluções para encontrar padrões locais.

Por exemplo, em uma imagem:

pixels

↓

filtros

↓

bordas

↓

formas

↓

objeto

Para o seu projeto atual, uma CNN seria desnecessária para seis características tabulares.

Seria como usar uma ferramenta muito mais especializada para um problema que não precisa dela.

37. Resumo das diferenças

Modelo | Ideia principal | Seu projeto
Perceptron | Separação simples | Muito limitado
Regressão logística | Classificação relativamente simples | Possível
Árvore | Regras/separações | Possível
Random Forest | Muitas árvores + votação | Possível
SVM | Fronteira ótima entre classes | Possível
KNN | Comparar com vizinhos | Possível, mas menos interessante embarcado
CNN | Padrões locais/estruturados | Desnecessária para suas features
LSTM | Sequências temporais | Interessante para séries temporais mais completas
MLP | Combinação não linear de características | Adequada ao seu caso

38. O motivo técnico da escolha do MLP no seu TCC

Eu explicaria para uma banca mais ou menos assim:

"Foi adotada uma rede Perceptron Multicamadas, ou MLP, devido à natureza tabular das variáveis extraídas do sistema de monitoramento e à necessidade de executar a inferência em um ESP32. A arquitetura 6→8→4→3 apresenta apenas 107 parâmetros treináveis, permitindo uma implementação compacta. As funções ReLU foram utilizadas nas camadas ocultas para introduzir não linearidade, enquanto a softmax foi empregada na saída para classificação multiclasse. O treinamento foi realizado offline no computador, utilizando entropia cruzada e o otimizador Adam, e posteriormente os parâmetros aprendidos foram incorporados ao firmware para inferência embarcada."

Isso já é uma explicação técnica de verdade.

39. E existe uma coisa muito importante no seu modelo

Seu sistema não é simplesmente "uma IA que olha a corrente".

Hoje ele faz:

MÁQUINA CNC

↓

PZEM-004T

↓

ESP32

↓

dados elétricos

↓

tratamento dos dados

↓

┌─────────────────────┐

│ 6 FEATURES │

│ │

│ Corrente │

│ Potência │

│ Fator de potência │

│ Δ corrente │

│ Média │

│ Desvio padrão │

└─────────────────────┘

↓

z-score

↓

MLP 6→8→4→3

↓

ReLU / ReLU

↓

Softmax

↓

┌──────────────┼──────────────┐

↓ ↓ ↓

PARADA VAZIO USINANDO

Enquanto SOBRECARGA e CRÍTICO são tratados por limiar fixo no firmware na versão atual.

Isso significa que seu sistema, hoje, é uma arquitetura híbrida de classificação: uma parte neural + uma parte baseada em limites.

40. A forma mais fácil de você memorizar o treinamento

Decore esta sequência:

1. ENTRADA

↓

2. FORWARD

↓

3. PREVISÃO

↓

4. LOSS

↓

5. BACKPROPAGATION

↓

6. GRADIENTE

↓

7. ADAM

↓

8. NOVOS PESOS

↓

9. PRÓXIMO MINI-BATCH

↓

10. PRÓXIMA ÉPOCA

↓

11. VALIDAÇÃO

↓

12. EARLY STOPPING

E uma frase que explica o MLP inteiro:

"O MLP recebe as seis características normalizadas, realiza transformações ponderadas através das camadas ocultas com ReLU, gera probabilidades por softmax, calcula a perda em relação ao rótulo correto e utiliza backpropagation e o otimizador Adam para ajustar os 107 parâmetros ao longo das épocas."

Essa é, essencialmente, a espinha dorsal do funcionamento do seu modelo.

E existe uma diferença importante entre "como o MLP funciona matematicamente" e "por que o seu projeto adotou MLP em vez de outros algoritmos". A primeira é arquitetura e treinamento; a segunda é uma decisão metodológica de engenharia. No seu TCC, vale separar essas duas discussões.
