gabrielgr04072005-ai/TCC-Fatec-Sistema-de-monitoramento-CNC/Treinamento TynML/Dados reais 23_08/erro_reconstrucao_dados_reais.png

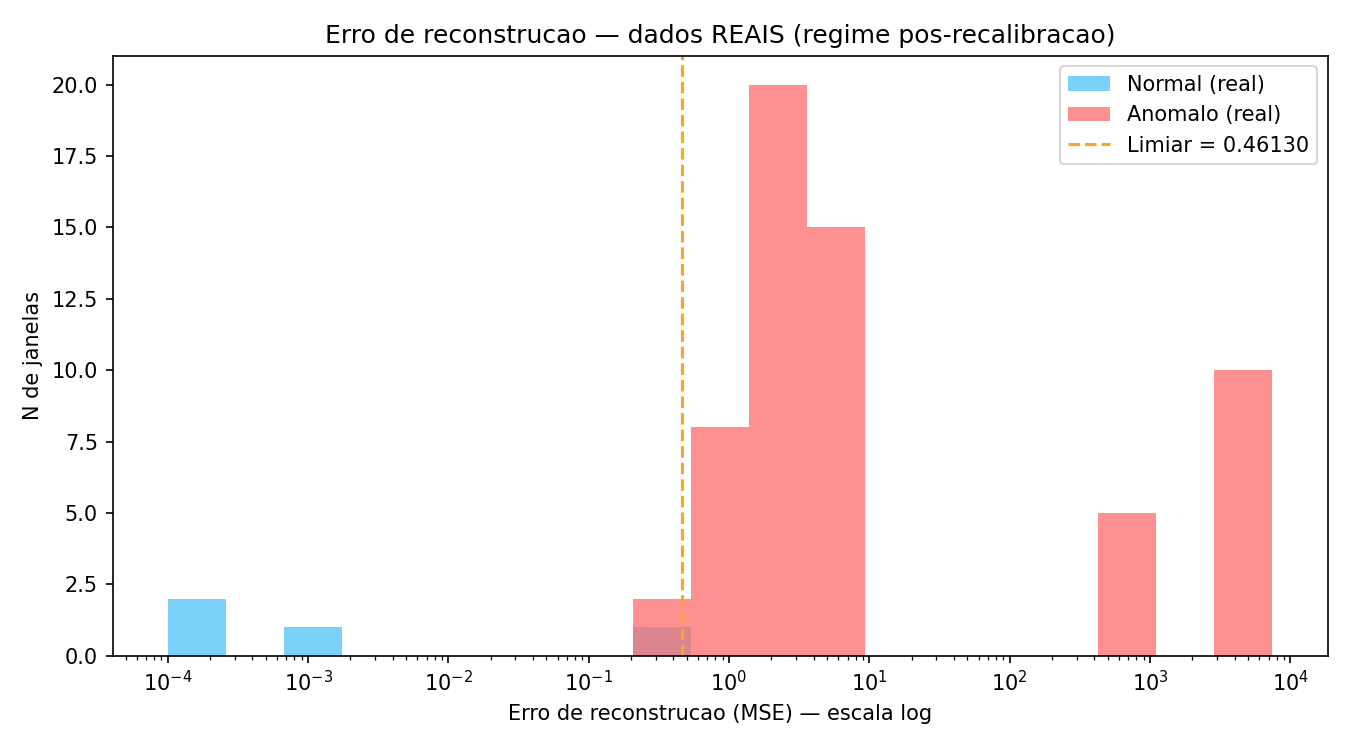
Treinamento TynML/Dados reais 23_08/erro_reconstrucao_dados_reais.png
