gabrielgr04072005-ai/TCC-Fatec-Sistema-de-monitoramento-CNC/Treinamento TynML/distribuicao_erro_reconstrucao_v1.png

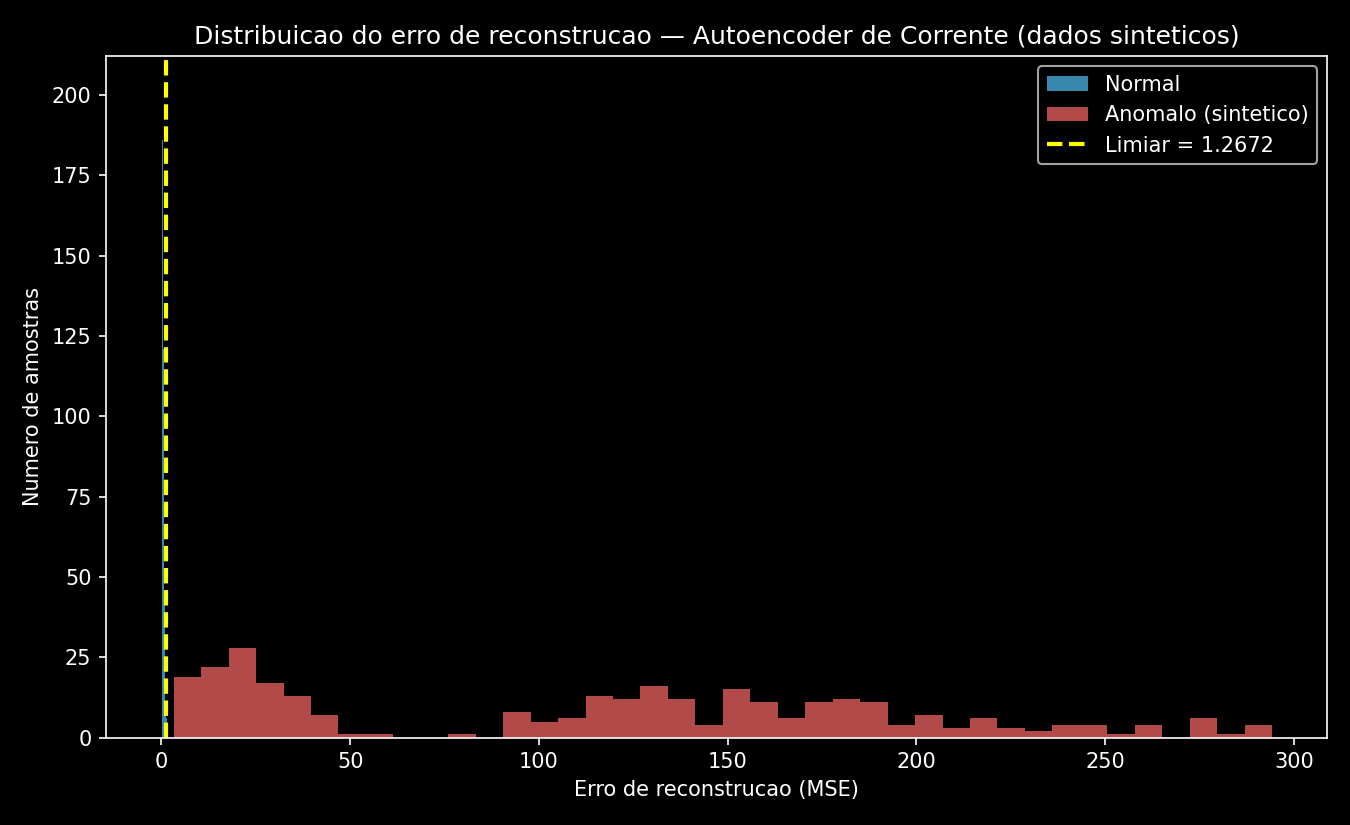
Treinamento TynML/distribuicao_erro_reconstrucao_v1.png
