gabrielgr04072005-ai/TCC-Fatec-Sistema-de-monitoramento-CNC/Testes/tempo_corrente.csv

Tempo (s) | Corrente (A)
1 | 0,2632
2 | 0,2622
3 | 0,2606
4 | 0,2592
5 | 0,263
6 | 0,2622
7 | 0,2627
8 | 0,2641
9 | 0,2597
10 | 0,2622
11 | 0,2671
12 | 0,2693
13 | 0,2668
14 | 0,2686
15 | 0,2711
16 | 0,271
17 | 0,2677
18 | 0,2686
19 | 0,2704
20 | 0,2691
21 | 0,2727
22 | 0,2712
23 | 0,269
24 | 0,2709
25 | 0,2698
26 | 0,2701
27 | 0,2701
28 | 0,2712
29 | 0,2734
30 | 0,2727
31 | 0,2723
32 | 0,2731
33 | 0,2726
34 | 0,2733
35 | 0,2695
36 | 0,2677
37 | 0,267
38 | 0,2698
39 | 0,2666
40 | 0,2669
41 | 0,2664
42 | 0,2636
43 | 0,2648
44 | 0,261
45 | 0,2624
46 | 0,2638
47 | 0,2635
48 | 0,2616
49 | 0,2638
50 | 0,2614
51 | 0,2612
52 | 0,2618
53 | 0,2613
54 | 0,2627
55 | 0,2625
56 | 0,2623
57 | 0,2625
58 | 0,2605
59 | 0,2639
60 | 0,262
61 | 0,2644
62 | 0,2622
63 | 0,2618
64 | 0,2641
65 | 0,2584
66 | 0,2631
67 | 0,2611
68 | 0,262
69 | 0,2614
70 | 0,264
71 | 0,2621
72 | 0,2601
73 | 0,2633
74 | 0,2634
75 | 0,2647
76 | 0,2675
77 | 0,2686
78 | 0,2684
79 | 0,2695
80 | 0,2646
81 | 0,268
82 | 0,269
83 | 0,2676
84 | 0,2667
85 | 0,271
86 | 0,2718
87 | 0,2674
88 | 0,2681
89 | 0,2729
90 | 0,2697
91 | 0,27
92 | 0,2687
93 | 0,2692
94 | 0,2724
95 | 0,2688
96 | 0,2734
97 | 0,2701
98 | 0,2715
99 | 0,2715
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
