gabrielgr04072005-ai/TCC-Fatec-Sistema-de-monitoramento-CNC/Mqtt/Dados brutos/Amostras_30.09/saida_tcc/04_teste_z.csv

corrente | potencia | pf | delta_corrente | media_corrente | desvio_corrente | estado | classe_id
-0,3090209443530334 | 0,12472325080505602 | 0,4022738684294754 | 0,010989553600764953 | -0,5567390912307435 | -0,6931792233037952 | VAZIO | 1
-0,3127755543410358 | 0,1146391645179483 | 0,4022738684294754 | 0,021704904844383876 | -0,5704589751758126 | -0,6890243832327083 | VAZIO | 1
-0,39162236408909673 | -0,006369870927353088 | 0,4022738684294754 | -1,482016053010084 | 1,0088521100567578 | 1,2364424573930741 | VAZIO | 1
0,5094840330315846 | -0,09460562593955076 | -0,44313333542483396 | -0,5569240623110173 | 1,4753281641891534 | 1,0895718422870921 | VAZIO | 1
-0,38786775410109264 | 0,021361366362195322 | 0,4022738684294754 | -0,8283796271493518 | 1,4562727698210003 | 1,108724912477493 | VAZIO | 1
-0,3991315840651016 | -0,024017021929790904 | 0,4022738684294754 | 0,014561337348637397 | 1,4379795912275715 | 1,1270004703869025 | VAZIO | 1
-0,4366776839451308 | -0,3996492361245747 | 0,4022738684294754 | -3,6215145179859136 | 1,8114653208433844 | 1,662096873656936 | VAZIO | 1
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
