gabrielgr04072005-ai/TCC-Fatec-Sistema-de-monitoramento-CNC/Mqtt/Dados brutos/Amostras_30.09/saida_tcc/treino_resultados.png

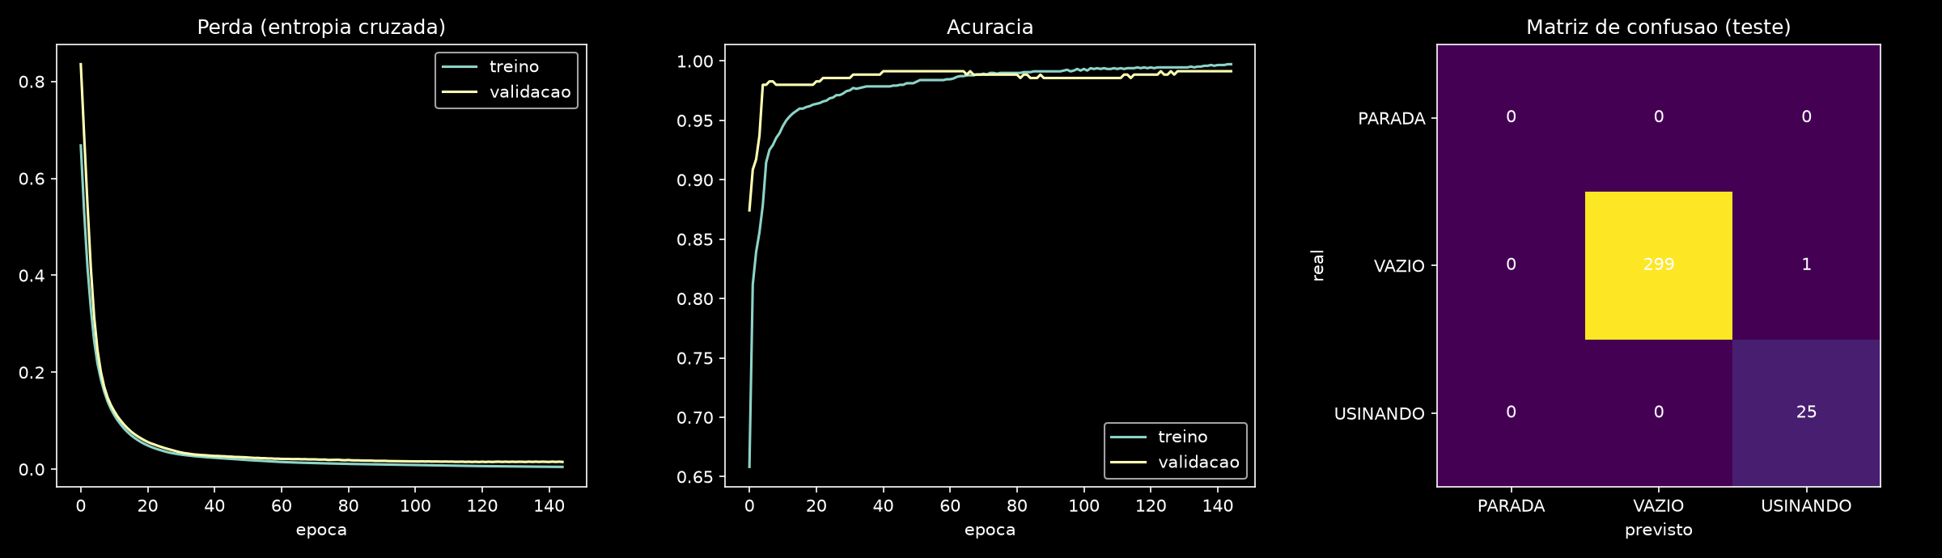
Mqtt/Dados brutos/Amostras_30.09/saida_tcc/treino_resultados.png
