gabrielgr04072005-ai/TCC-Fatec-Sistema-de-monitoramento-CNC/Testes/Gráficos/grafico_estilo_documento.png

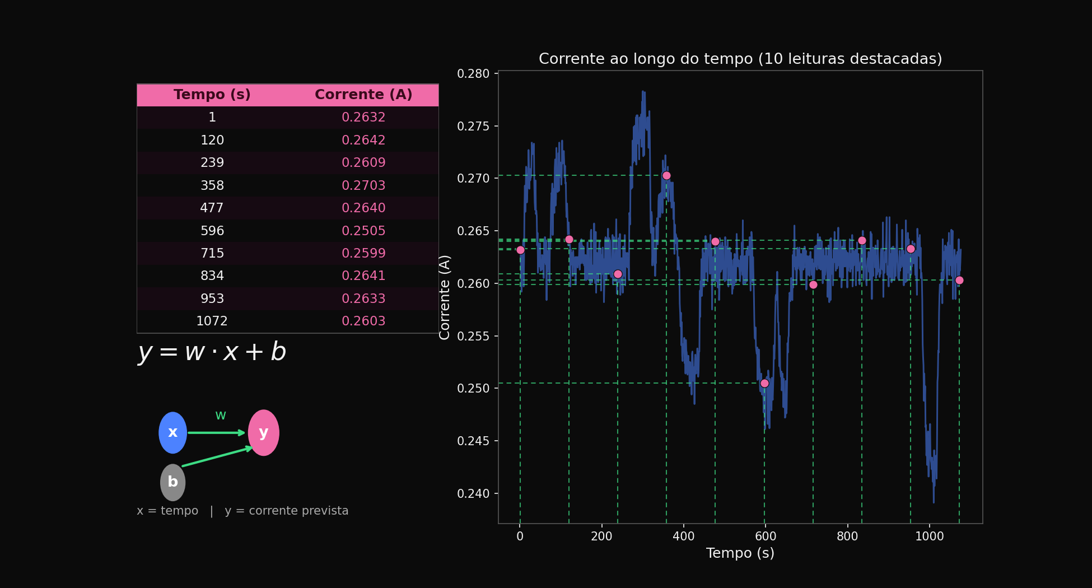
Testes/Gráficos/grafico_estilo_documento.png
