gabrielgr04072005-ai/TCC-Fatec-Sistema-de-monitoramento-CNC/Testes/Gráficos/previsao_corrente_mlp.png

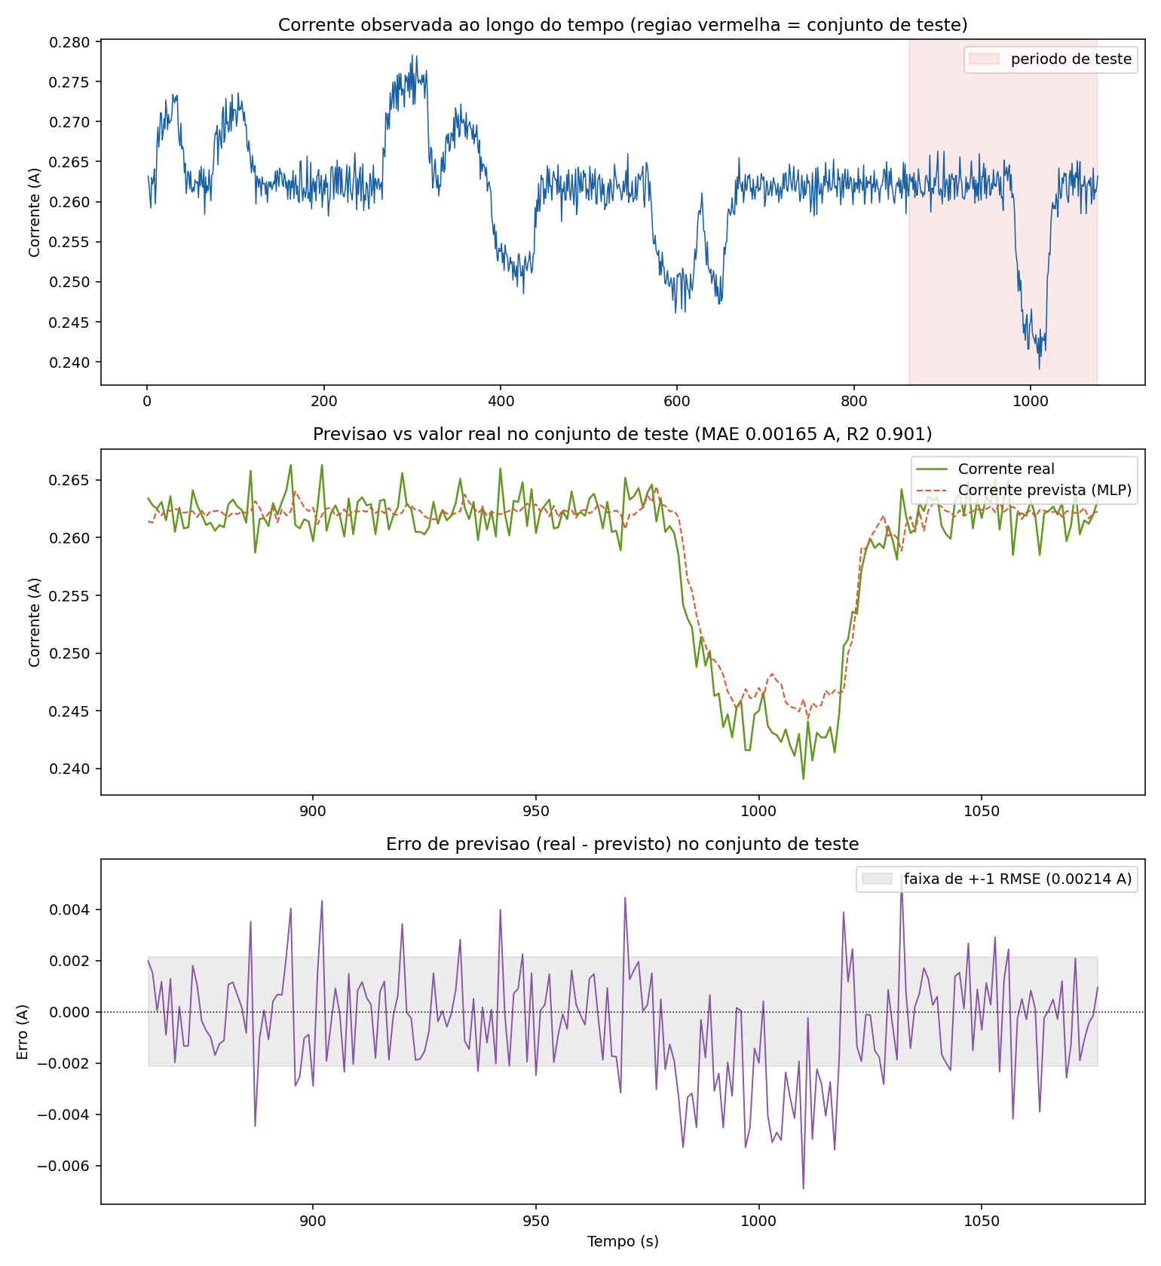
Testes/Gráficos/previsao_corrente_mlp.png
